ZaowuHT/JussieuServiceRobot/bom_list.xls

选型表 (Rev 0.4)
走行与运动硬件组件
编号 | 名称 | 型号 | 主要参数 | 数量 | 总价 | 评论
1 | 直流编码器减速电机 | CHR-36GP-555 | 减速比1:51 空载转速115RPM 扭矩20kg/cm 15线霍尔编码器 | 2 | 276 | 服务机器人位移速度不需要非常快，配合高扭矩电机提供更大的动力
2 | 直流电机驱动 | 7A160W | 双路L298逻辑桥电机驱动 单路最大输出电流7A | 1 | 36 | 大功率电机使用的大功率直流电机驱动，L298逻辑，控制电流与驱动电流光耦隔离
3 | AGV万向减震脚轮 | JQR25310-55ALCPU621 | 3寸，两级减震 | 1 | 112 | 两级弹簧减震悬挂，保证主动轮接地
4 | 实心橡胶承重轮 | - | 直径125mm 8mm安装轴 免维护 | 2 | 118 | 用于差速底盘
5 | 伺服电机 | SRC-04B | 回转角度270° 扭矩380kg/cm | 1 | 280 | 用于控制机器人抬头等功能，预留
6 | 伺服电机轮盘 | - | - | 1 | 36 | 出轴扭矩盘
7 | 伺服电机支架 | - | - | 1 | 20 | 伺服电机支架
8 | TTL舵机驱动器 | - | 16路 TTL电平控制 | 1 | 36 | 内置STM32控制器，与主控通过TTL串口连接，简化伺服电机控制程序
9 | STM32F407ZGT6 | STM32F407ZGT6 | Cortex-M4 核心，168Mhz主频 | 1 | 106 | 可运行FreeRTOS实时操作系统
10 | 动力锂电池组 | - | 12V 32Ah | 1 | 480 | 4A持续放电8小时，基本满足续航要求
11 | 12V稳压器 | WG8-36S1220 | 最大输出电压电流 12V 20A | 1 | 162 | 电池电压9-12V，保证电路电压稳定在12V
12 | 回转支承轴承 | - | 外径20 内径14 | 1 | 30 | 用于机器人上半身的旋转
13 | PCB制作打样 | - | - | 1 | 165 | 使用PCB综合各模块与电子部件
14 | 标准零部件 | - | - | 若干 | 待定 | 包含铝型材、电子与机械标准零部件等
 |  |  |  |  | 1857
连接与通讯，传感器，交互硬件组件
编号 | 名称 | 型号 | 主要参数 | 数量 | 总价 | 评论
1 | RS232转TTL模块 | MAX3232 | 采用RS232与上位机通讯 | 1 | 1.6 | 用于连接机器视觉模块、下位机主控
2 | SLAMWARE导航模块 | SLAMWARE Core | 激光雷达驱动、SLAM算法加速模块 | 1 | 2000 | 国产SLAM算法加速模块，内置激光雷达驱动、九轴加速度传感器
3 | 激光雷达 | RPLIDAR A2M7 | 16m扫描半径 16K采样点数 | 1 | 2200 | 激光雷达传感器
4 | Astra Pro 深度摄像头 | Astra Pro | 720p摄像头，8m深度摄像头 | 1 | 163 | 用于人脸识别，深度信息避障等
5 | 麦克风阵列 | - | 四麦克风阵列，5m拾音 | 1 | 65 | 用于语音采集，人脸识别
6 | 通用USB供电音箱 | - | - | 1 | 50 | 用于语音播报，音频回放等
7 | 超声波测距传感器 | DYP-A02-V2.0 | USART输出，分时复用 | 6 | 348 | 用于运行时障碍物检测
8 | 工控计算机 | - | J1900四核处理器 4G+32G WiFi 双路RS232 | 1 | 930 | 上位机，运行交互前端与ROS框架
9 | 15英寸触摸屏 | - | 1080p HDMI | 1 | 869 | 用于前端交互
 |  |  |  |  | 6626.6
机器人结构，外壳组件
编号 | 名称 | 型号 | 主要参数 | 数量 | 总价 | 评论
1 | 铝型材框架 | 1010/2020/4040 | - | 若干 | 待定 | 用于搭建机器人骨架
2 | 亚克力板 | 6mm/8mm/10mm | - | 若干 | 待定 | 用于机器人外壳设计
3 | 机械标准件 | - | - | 若干 | 待定 | 用于结构安装
 |  |  |  |  | 待定
