ZaowuHT/JussieuServiceRobot/pcb_bom.xlsx

PCB板BOM清单
名称 | 封装 | 数量 | 备注
供电连接器 | KF128-5.08-2P | 5
