ZaowuHT/JussieuServiceRobot/blueprint_platform/motor_wheel.SLDASM

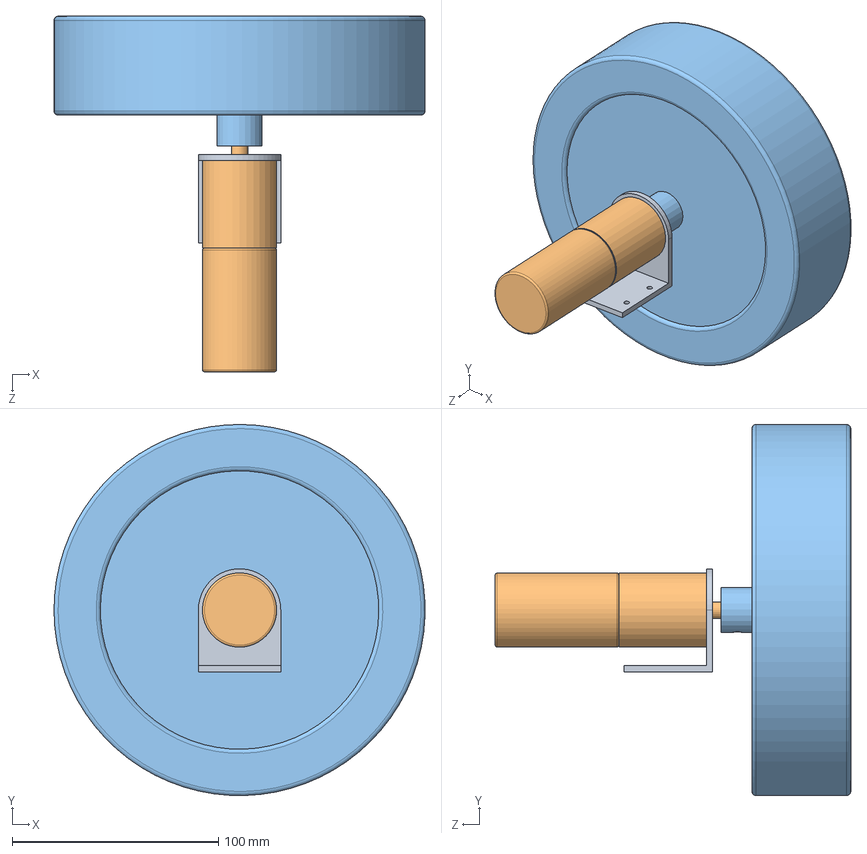
[picture p1: CAD file, 2020-09-28]
blueprint_platform/motor_wheel.SLDASM
179.9 x 180.0 x 172.5 mm
motor_plat
motor
wheel
