ZaowuHT/JussieuServiceRobot/blueprint_platform/movebase.SLDASM

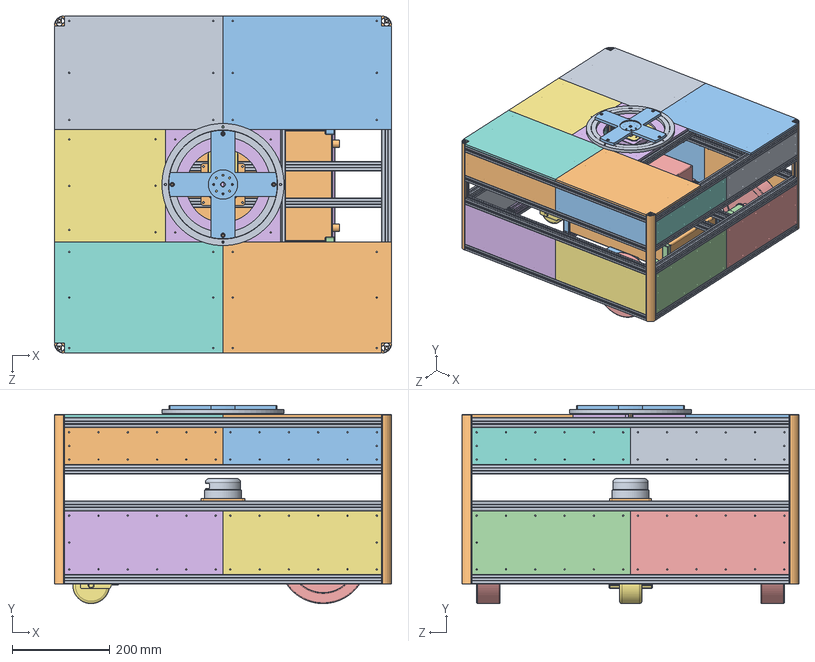
[picture p2: CAD file, 2020-09-28]
blueprint_platform/movebase.SLDASM
690.2 x 405.8 x 690.1 mm
2020R_Movebase x 4
motor_plat x 2
motor x 2
wheel x 2
wheel_3
wheel_3_plat
battery
battery_plat x 2
battery_plat_mirror x 2
host_computer
pcb
pcb_plat
stud_M3x40 x 4
lidar
lidar_plat
battery_stabilizer
battery_stabilizer_plat
servo
servo_plat
servo_wheel
turntable
stud_M5x8 x 8
turntable_plat
acrylic_325x130_left_down_l
acrylic_325x130_left_down_r
acrylic_325x130_front_down_l
acrylic_325x130_front_down_r
acrylic_325x130_right_down_l
acrylic_325x130_right_down_r
acrylic_325x130_rear_down_l
acrylic_325x130_rear_down_r
acrylic_325x75.8_front_up_l
acrylic_325x75.8_front_up_r
acrylic_325x75.8_rear_up_l
acrylic_325x75.8_rear_up_r
acrylic_325x75.8_left_up_l
acrylic_325x75.8_left_up_r
acrylic_325x75.8_right_up_l
acrylic_325x75.8_right_up_r
acrylic_256x225.45_top_mid
acrylic_227x230.45_top_front_mid
acrylic_227x345_top_left_l
acrylic_227x345_top_right_r
acrylic_227x345_top_left_r
acrylic_227x345_top_right_l
