ZaowuHT/JussieuServiceRobot/blueprint_prototype/motor_wheel.SLDASM

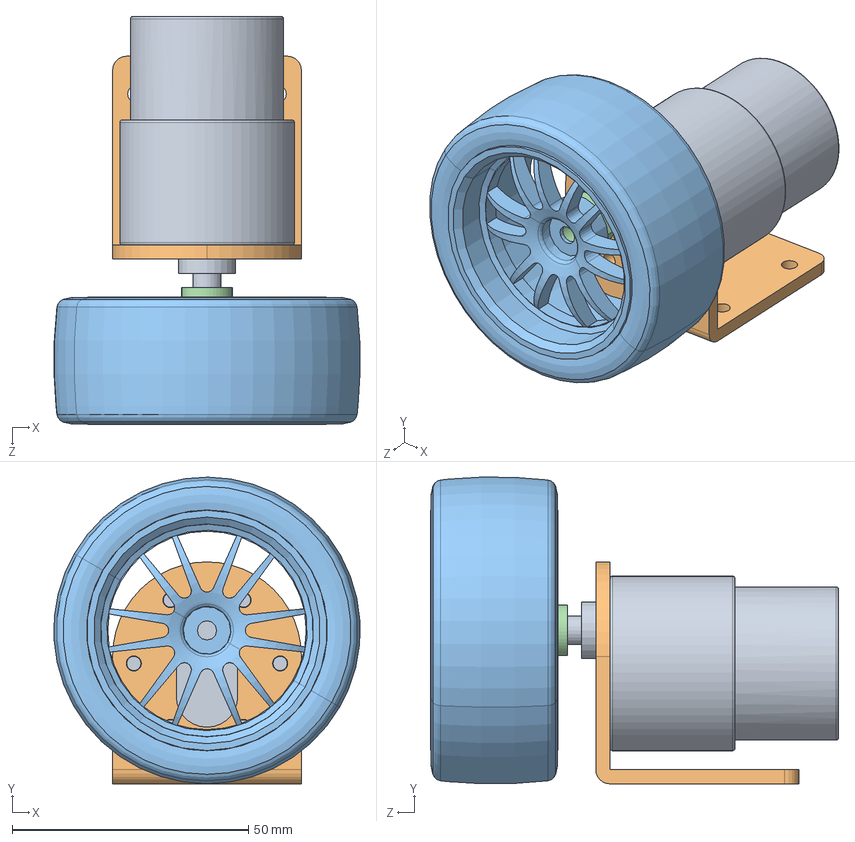
[picture p3: CAD file, 2020-09-28]
blueprint_prototype/motor_wheel.SLDASM
64.8 x 65.0 x 86.4 mm
motor
plat_motor
wheel
connector
