ZaowuHT/JussieuServiceRobot/blueprint_prototype/prototype.SLDASM

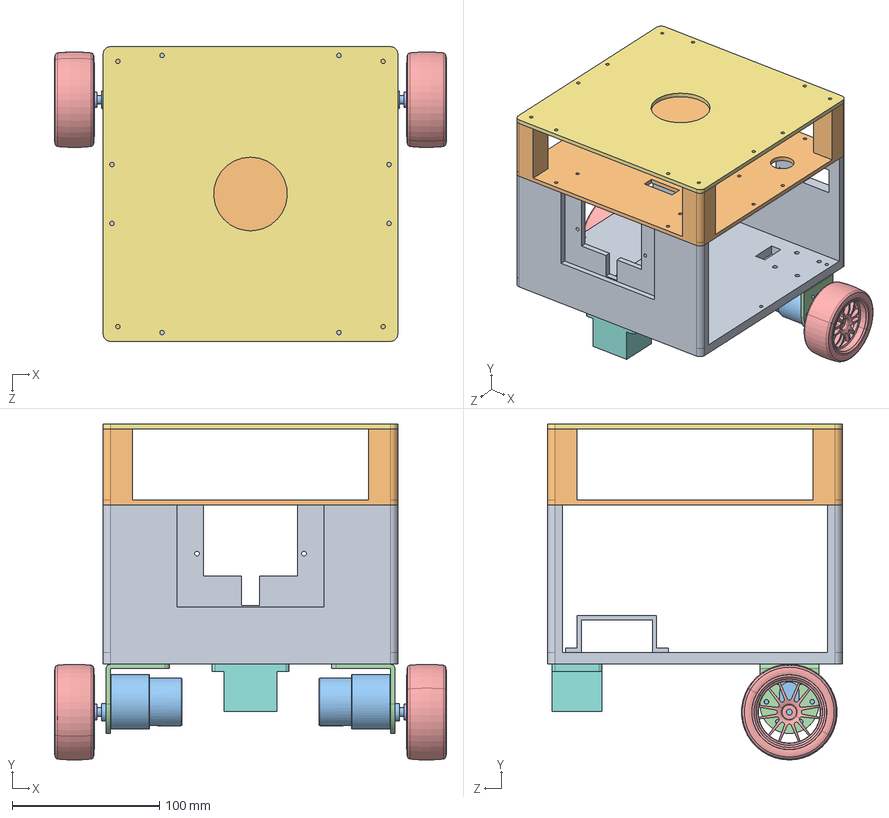
[picture p4: CAD file, 2020-09-28]
blueprint_prototype/prototype.SLDASM
266.0 x 228.0 x 200.0 mm
plat_main
plat_mid
motor x 2
plat_motor x 2
wheel x 2
connector x 2
plat_up
plat_wheel
batt_plat
