ZaowuHT/JussieuServiceRobot/blueprint_prototype/plat_main.SLDPRT

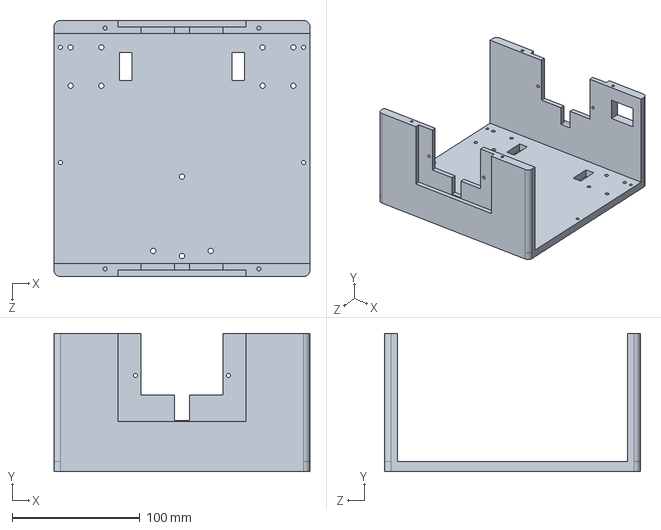
[picture p5: CAD file, 2020-09-28]
blueprint_prototype/plat_main.SLDPRT
200.0 x 108.0 x 200.0 mm
