ZaowuHT/JussieuServiceRobot/blueprint_platform/robot_body.SLDASM

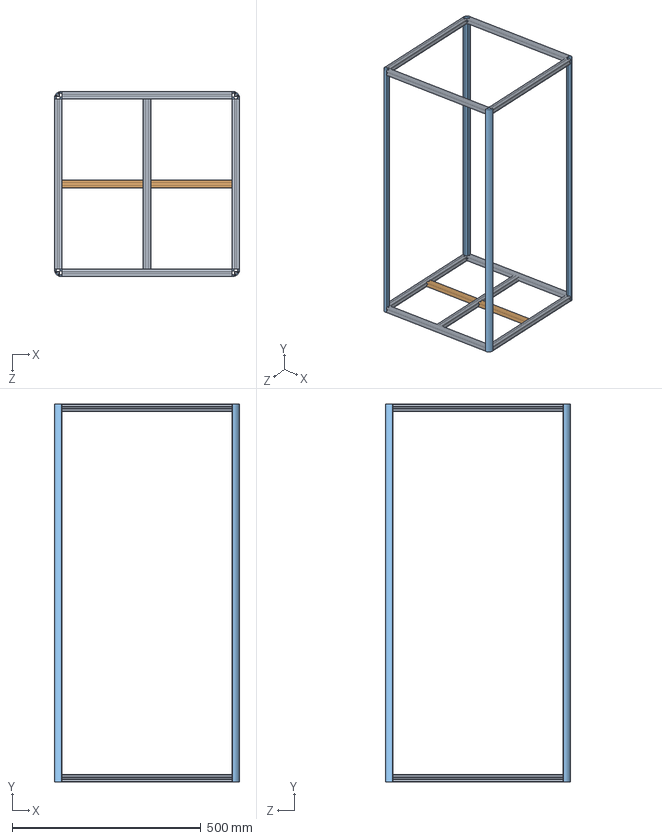
[picture p6: CAD file, 2020-09-28]
blueprint_platform/robot_body.SLDASM
490.2 x 1000.0 x 490.2 mm
2020R_body x 4
