ZaowuHT/JussieuServiceRobot/blueprint_platform/acrylic/acrylic_227x345_top_right_l.SLDPRT

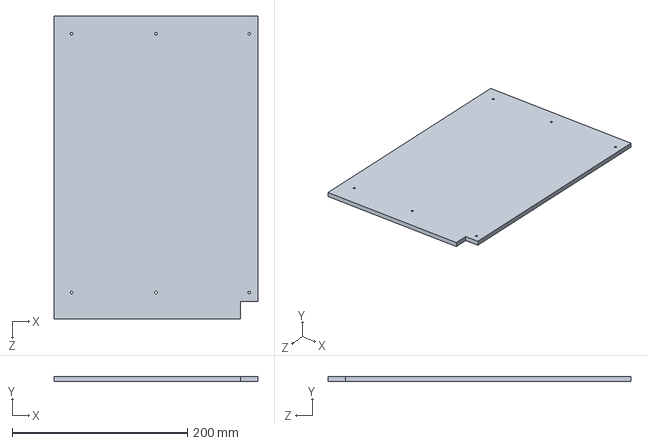
[picture p7: CAD file, 2020-09-28]
blueprint_platform/acrylic/acrylic_227x345_top_right_l.SLDPRT
232.5 x 6.00 x 345.0 mm
