ZaowuHT/JussieuServiceRobot/blueprint_platform/aluminum_profile/2040_216.SLDPRT

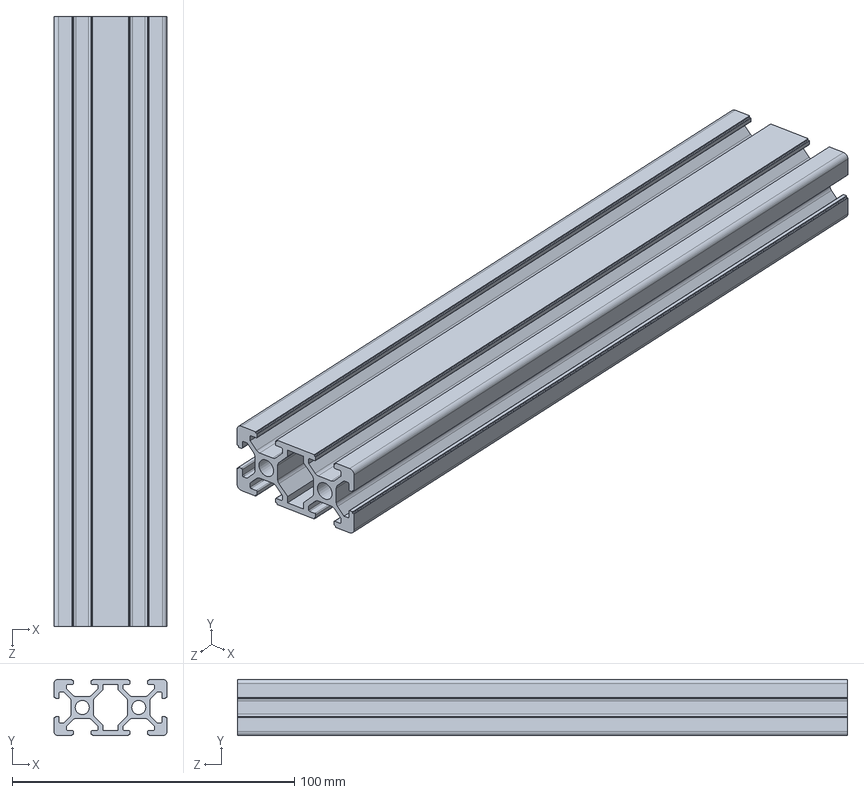
[picture p8: CAD file, 2020-09-28]
blueprint_platform/aluminum_profile/2040_216.SLDPRT
40.0 x 20.0 x 216.0 mm
