ZaowuHT/JussieuServiceRobot/blueprint_platform/pcb_plat.SLDPRT

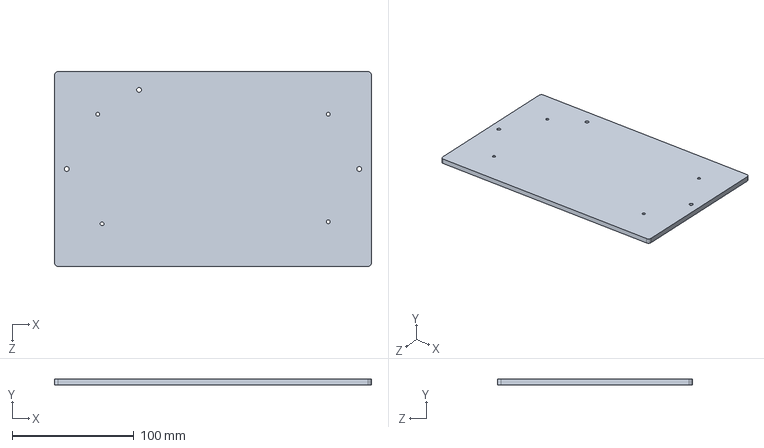
[picture p9: CAD file, 2020-09-28]
blueprint_platform/pcb_plat.SLDPRT
260.0 x 5.00 x 160.0 mm
