ZaowuHT/JussieuServiceRobot/blueprint_prototype/motor.SLDPRT

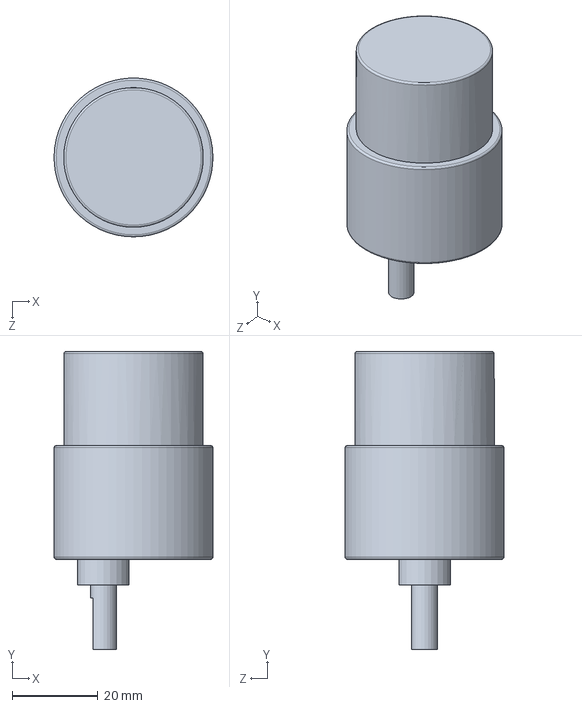
[picture p10: CAD file, 2020-09-28]
blueprint_prototype/motor.SLDPRT
37.0 x 69.4 x 37.0 mm
