ZaowuHT/JussieuServiceRobot/blueprint_platform/acrylic/acrylic_325x75.8_right_up_l.SLDPRT

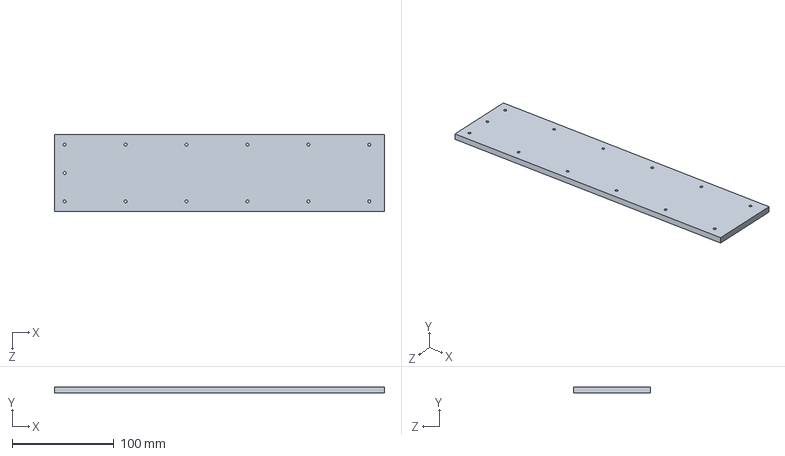
[picture p11: CAD file, 2020-09-28]
blueprint_platform/acrylic/acrylic_325x75.8_right_up_l.SLDPRT
325.0 x 6.00 x 75.8 mm
