ZaowuHT/JussieuServiceRobot/blueprint_platform/aluminum_profile/2020R_Movebase.SLDPRT

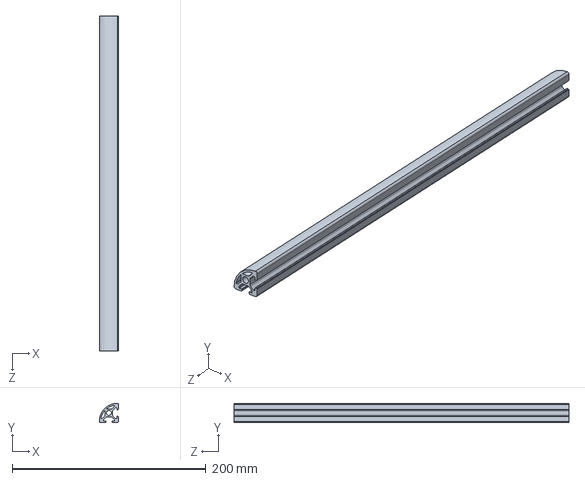
[picture p12: CAD file, 2020-09-28]
blueprint_platform/aluminum_profile/2020R_Movebase.SLDPRT
20.1 x 20.1 x 346.0 mm
