ZaowuHT/JussieuServiceRobot/blueprint_prototype/plat_wheel.SLDPRT

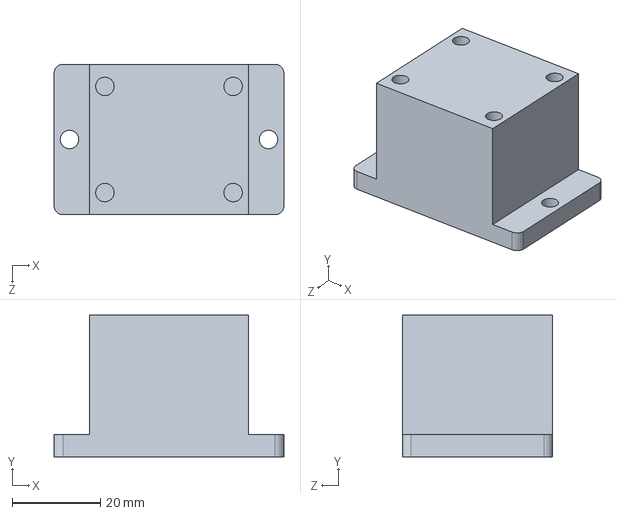
[picture p13: CAD file, 2020-09-28]
blueprint_prototype/plat_wheel.SLDPRT
52.0 x 32.0 x 34.0 mm
