ZaowuHT/JussieuServiceRobot/blueprint_platform/aluminum_profile/2020R_body.SLDPRT

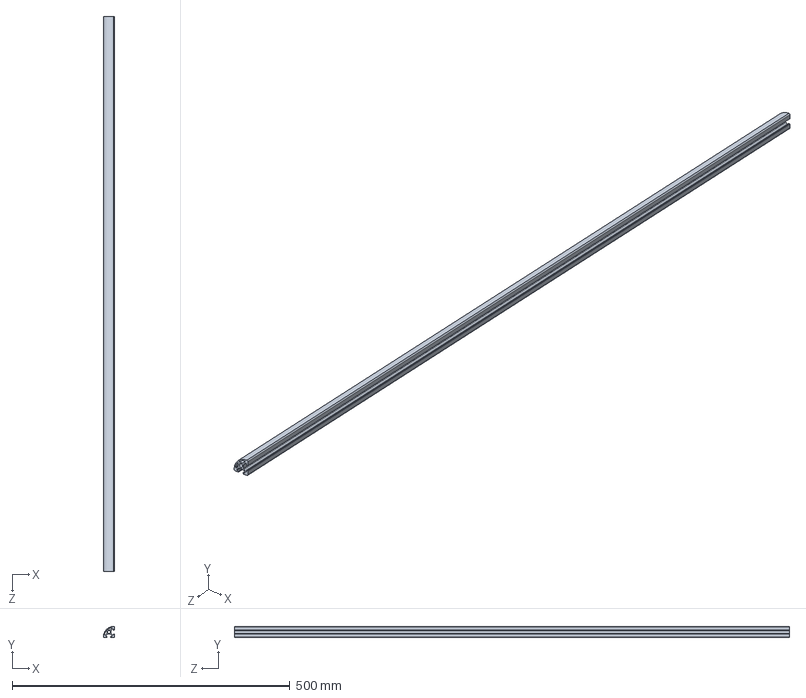
[picture p14: CAD file, 2020-09-28]
blueprint_platform/aluminum_profile/2020R_body.SLDPRT
20.1 x 20.1 x 1000.0 mm
