ZaowuHT/JussieuServiceRobot/blueprint_platform/motor.SLDPRT

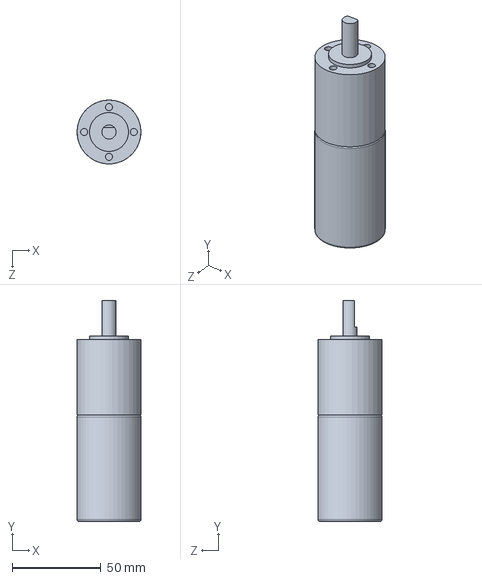
[picture p15: CAD file, 2020-09-28]
blueprint_platform/motor.SLDPRT
36.0 x 124.5 x 36.0 mm
