ZaowuHT/JussieuServiceRobot/blueprint_prototype/batt_plat.SLDPRT

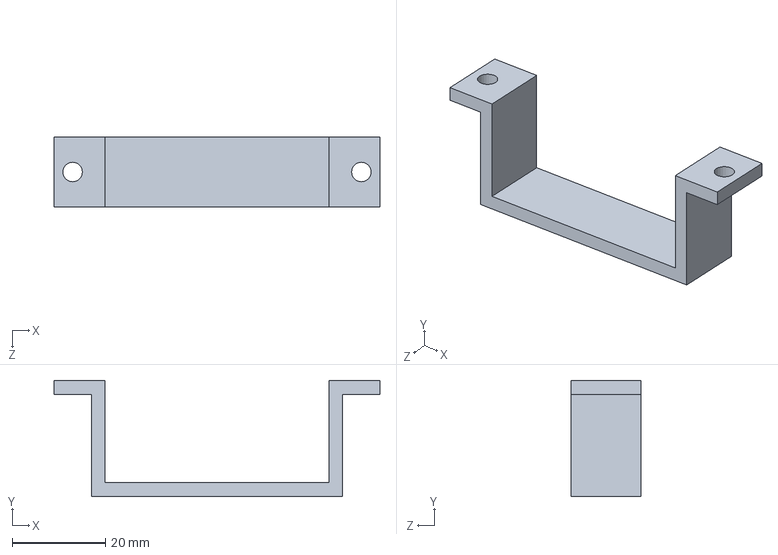
[picture p16: CAD file, 2020-09-28]
blueprint_prototype/batt_plat.SLDPRT
70.0 x 25.0 x 15.0 mm
