ZaowuHT/JussieuServiceRobot/blueprint_platform/aluminum_profile/2020_450.SLDPRT

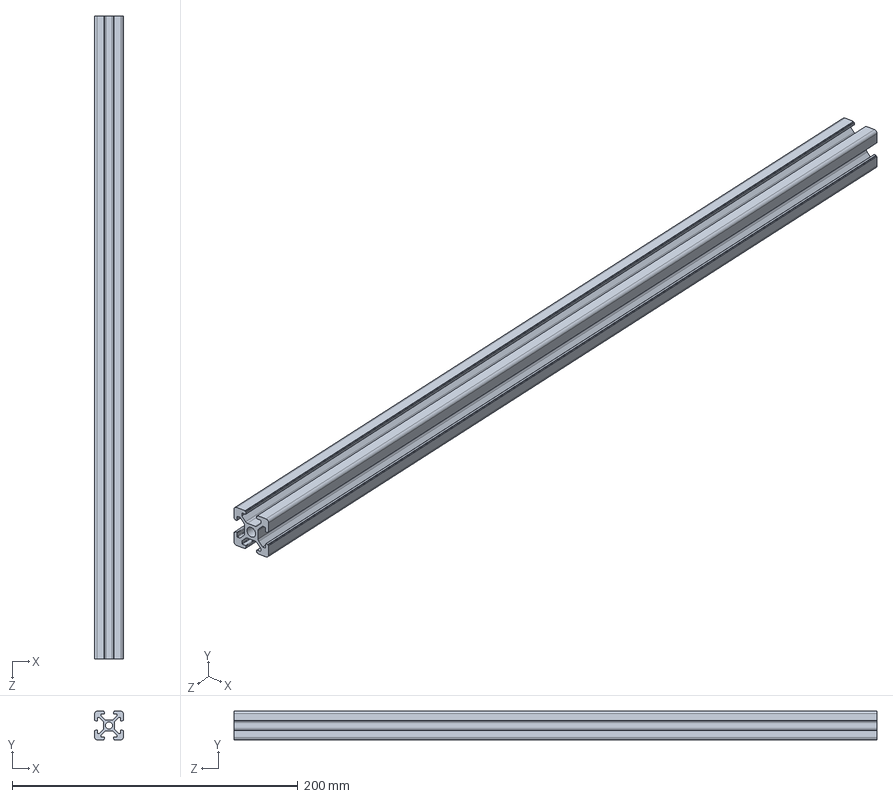
[picture p17: CAD file, 2020-09-28]
blueprint_platform/aluminum_profile/2020_450.SLDPRT
20.0 x 20.0 x 450.0 mm
