ZaowuHT/JussieuServiceRobot/blueprint_platform/lidar_plat.SLDPRT

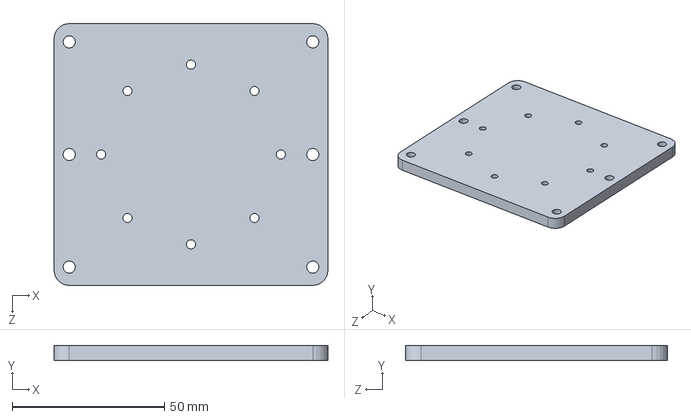
[picture p18: CAD file, 2020-09-28]
blueprint_platform/lidar_plat.SLDPRT
90.0 x 5.00 x 86.0 mm
