ZaowuHT/JussieuServiceRobot/blueprint_prototype/plat_up.SLDPRT

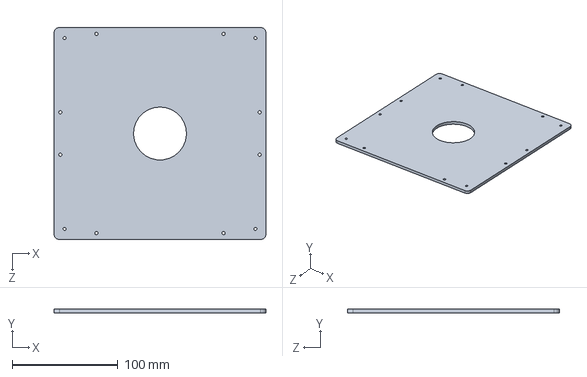
[picture p19: CAD file, 2020-09-28]
blueprint_prototype/plat_up.SLDPRT
200.0 x 3.50 x 200.0 mm
