ZaowuHT/JussieuServiceRobot/blueprint_platform/acrylic/acrylic_256x225.45_top_mid.SLDPRT

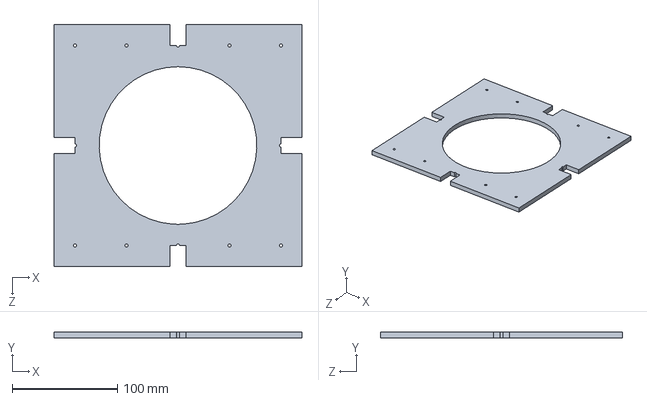
[picture p20: CAD file, 2020-09-28]
blueprint_platform/acrylic/acrylic_256x225.45_top_mid.SLDPRT
236.0 x 6.00 x 230.4 mm
