ZaowuHT/JussieuServiceRobot/blueprint_platform/battery_stabilizer.SLDPRT

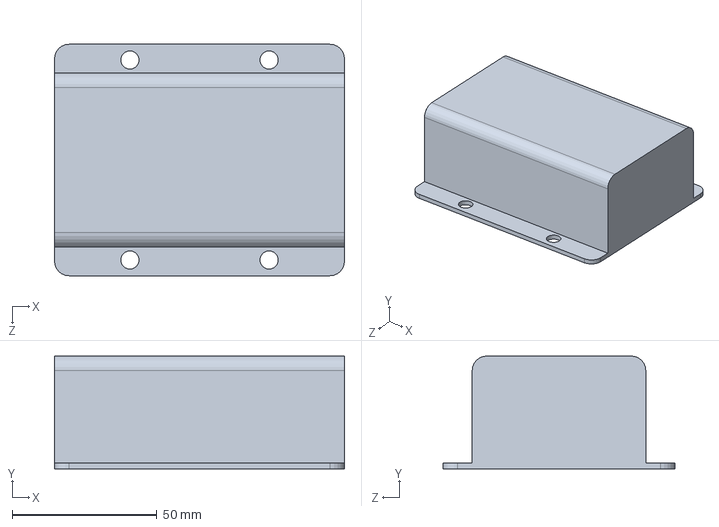
[picture p21: CAD file, 2020-09-28]
blueprint_platform/battery_stabilizer.SLDPRT
100.2 x 39.0 x 80.0 mm
