ZaowuHT/JussieuServiceRobot/blueprint_prototype/wheel.SLDPRT

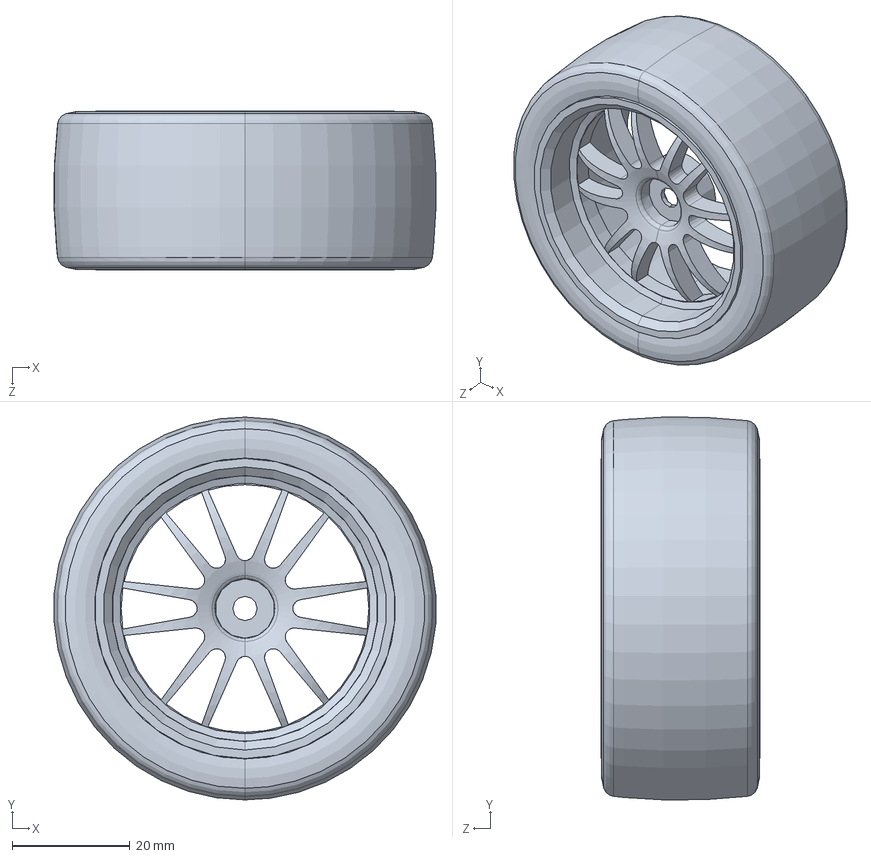
[picture p22: CAD file, 2020-09-28]
blueprint_prototype/wheel.SLDPRT
64.8 x 64.9 x 27.0 mm
