ZaowuHT/JussieuServiceRobot/blueprint_platform/acrylic/acrylic_325x130_front_down_l.SLDPRT

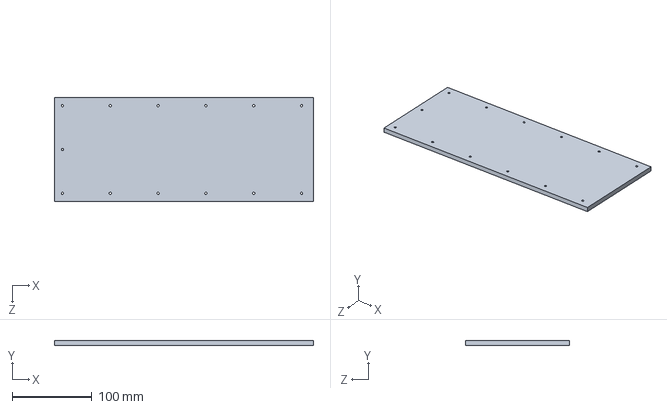
[picture p23: CAD file, 2020-09-28]
blueprint_platform/acrylic/acrylic_325x130_front_down_l.SLDPRT
325.0 x 6.00 x 130.0 mm
