ZaowuHT/JussieuServiceRobot/blueprint_platform/aluminum_profile/2020_Connect.SLDPRT

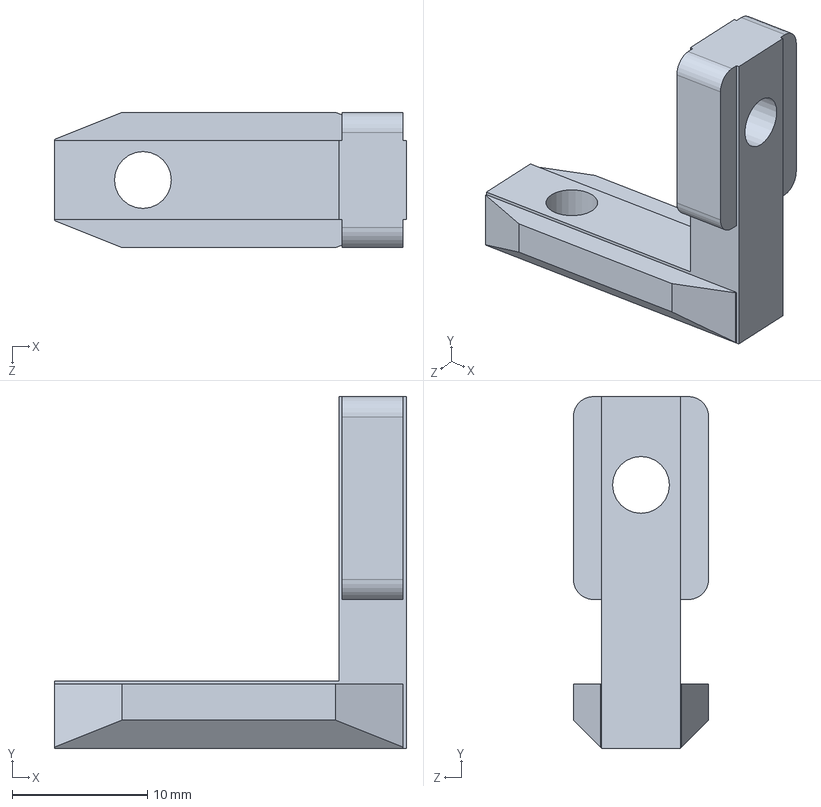
[picture p24: CAD file, 2020-09-28]
blueprint_platform/aluminum_profile/2020_Connect.SLDPRT
26.0 x 26.0 x 10.0 mm
