ZaowuHT/JussieuServiceRobot/blueprint_platform/servo.SLDPRT

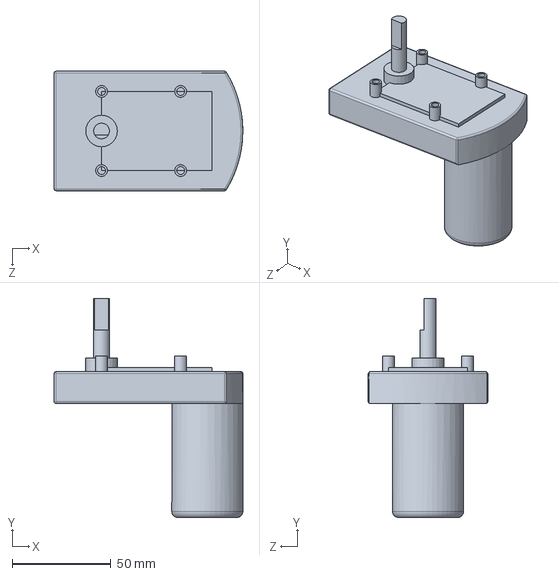
[picture p25: CAD file, 2020-09-28]
blueprint_platform/servo.SLDPRT
95.5 x 110.8 x 60.5 mm
