ZaowuHT/JussieuServiceRobot/blueprint_prototype/plat_motor.SLDPRT

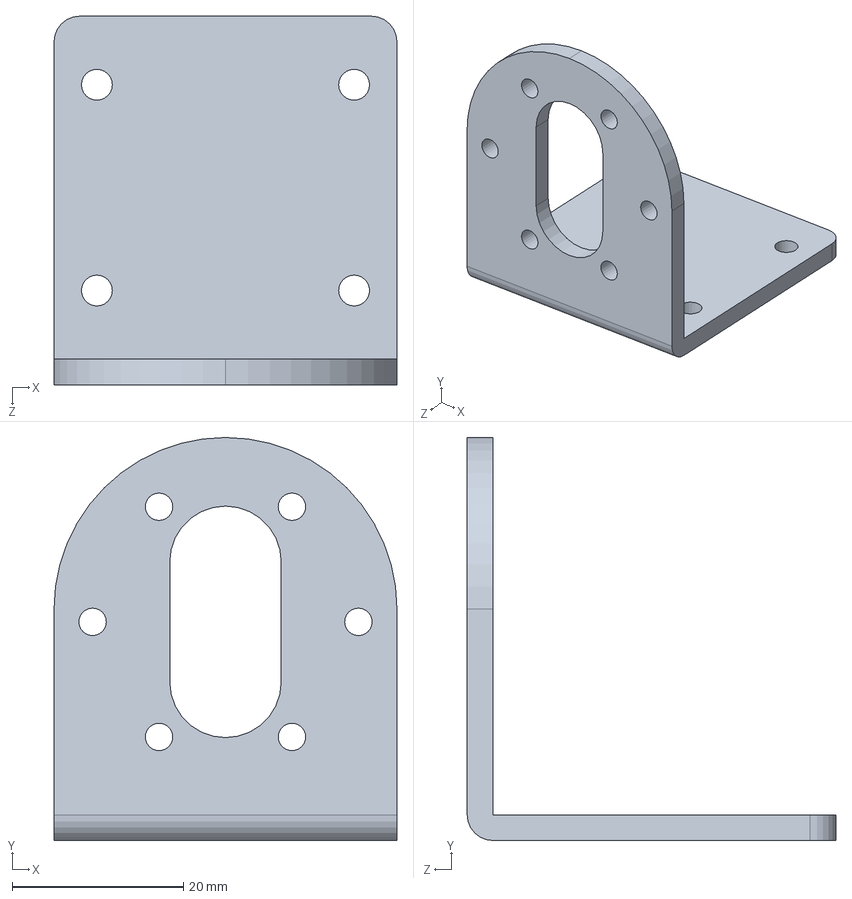
[picture p26: CAD file, 2020-09-28]
blueprint_prototype/plat_motor.SLDPRT
40.0 x 47.0 x 43.0 mm
