ZaowuHT/JussieuServiceRobot/blueprint_platform/aluminum_profile/2020_335.SLDPRT

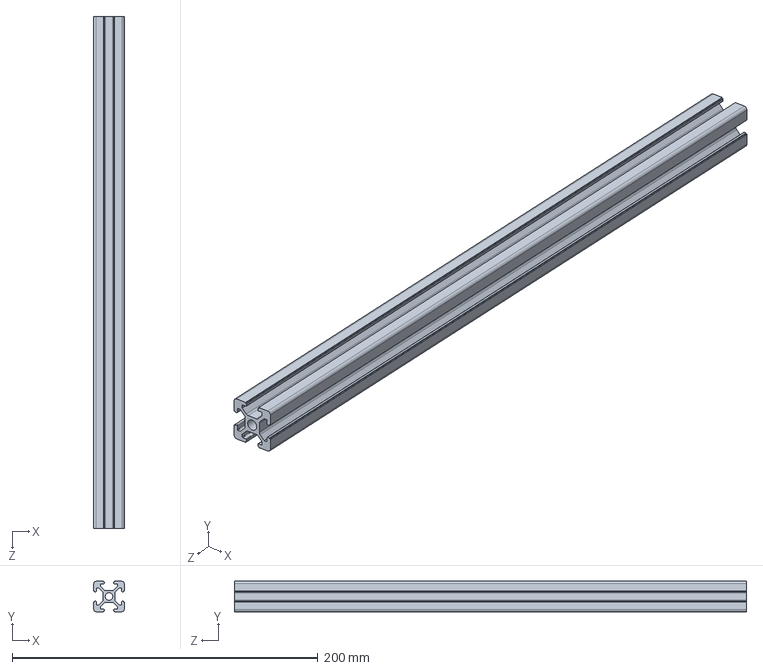
[picture p27: CAD file, 2020-09-28]
blueprint_platform/aluminum_profile/2020_335.SLDPRT
20.0 x 20.0 x 335.0 mm
