ZaowuHT/JussieuServiceRobot/blueprint_platform/aluminum_profile/2020_410.SLDPRT

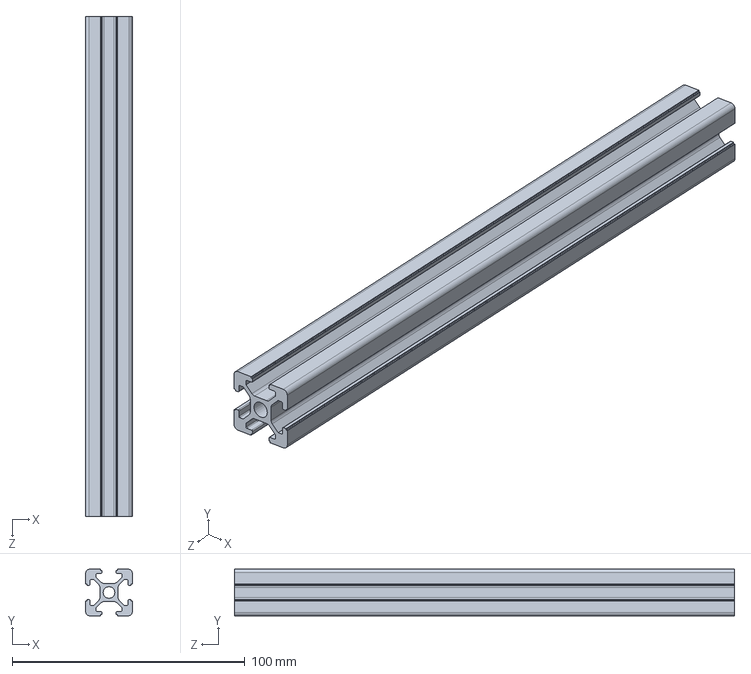
[picture p28: CAD file, 2020-09-28]
blueprint_platform/aluminum_profile/2020_410.SLDPRT
20.0 x 20.0 x 215.0 mm
