ZaowuHT/JussieuServiceRobot/blueprint_platform/battery_plat.SLDPRT

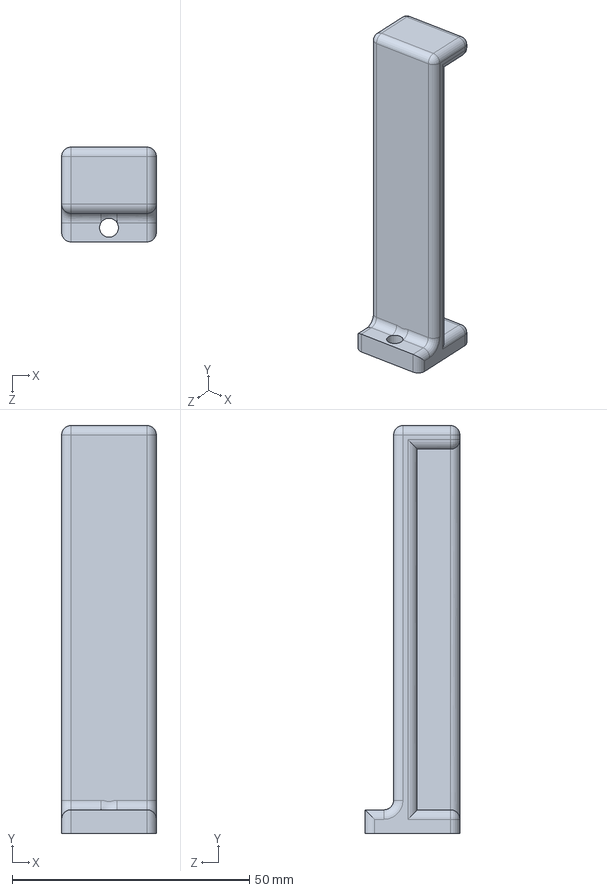
[picture p29: CAD file, 2020-09-28]
blueprint_platform/battery_plat.SLDPRT
20.0 x 86.0 x 20.0 mm
