ZaowuHT/JussieuServiceRobot/blueprint_prototype/plat_mid.SLDPRT

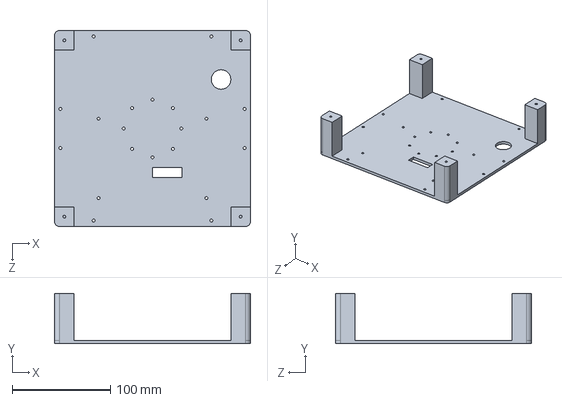
[picture p30: CAD file, 2020-09-28]
blueprint_prototype/plat_mid.SLDPRT
200.0 x 51.5 x 200.0 mm
