ZaowuHT/JussieuServiceRobot/blueprint_platform/battery_stabilizer_plat.SLDPRT

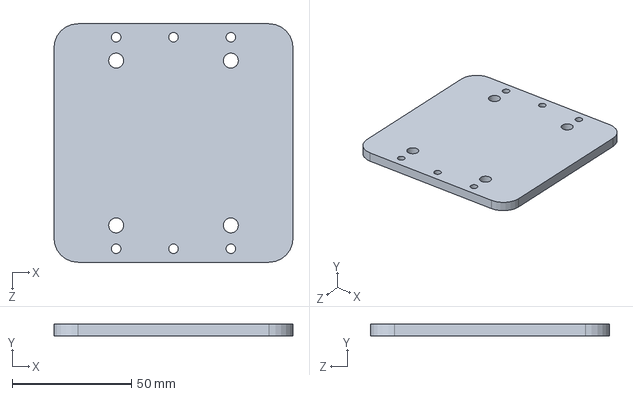
[picture p31: CAD file, 2020-09-28]
blueprint_platform/battery_stabilizer_plat.SLDPRT
100.2 x 5.00 x 100.0 mm
