ZaowuHT/JussieuServiceRobot/blueprint_platform/aluminum_profile/2020.SLDPRT

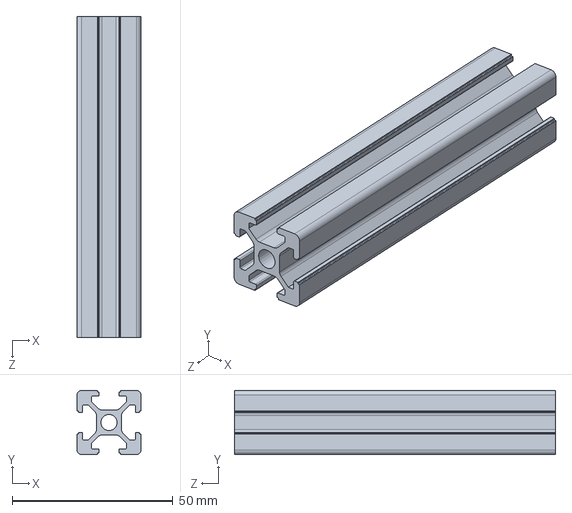
[picture p32: CAD file, 2020-09-28]
blueprint_platform/aluminum_profile/2020.SLDPRT
20.0 x 20.0 x 100.0 mm
