ZaowuHT/JussieuServiceRobot/blueprint_platform/body_speaker.SLDPRT

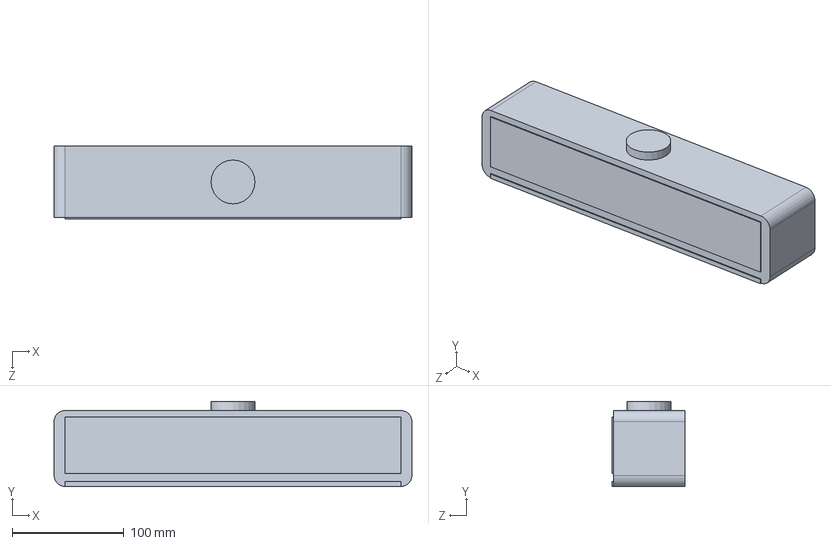
[picture p33: CAD file, 2020-09-28]
blueprint_platform/body_speaker.SLDPRT
320.0 x 76.0 x 65.0 mm
