ZaowuHT/JussieuServiceRobot/blueprint_prototype/connector.SLDPRT

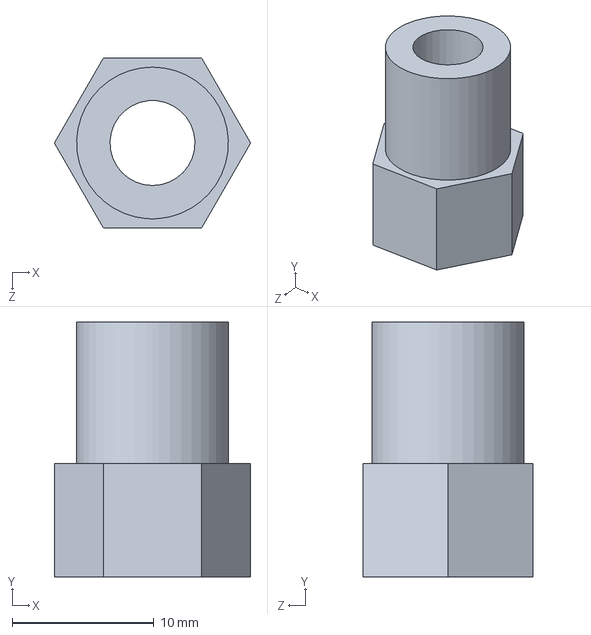
[picture p34: CAD file, 2020-09-28]
blueprint_prototype/connector.SLDPRT
13.9 x 18.0 x 12.0 mm
