ZaowuHT/JussieuServiceRobot/blueprint_platform/acrylic/acrylic_227x345_top_left_r.SLDPRT

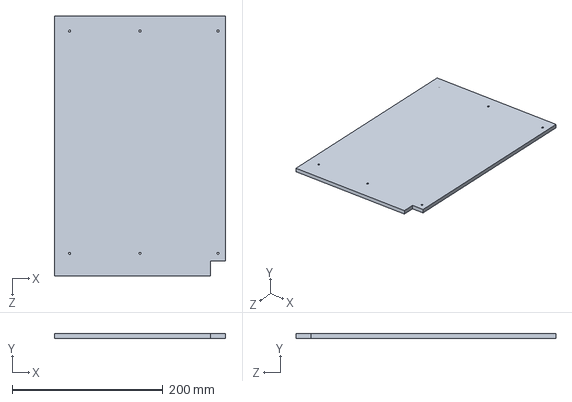
[picture p35: CAD file, 2020-09-28]
blueprint_platform/acrylic/acrylic_227x345_top_left_r.SLDPRT
227.0 x 6.00 x 345.0 mm
