ZaowuHT/JussieuServiceRobot/blueprint_platform/motor_plat.SLDPRT

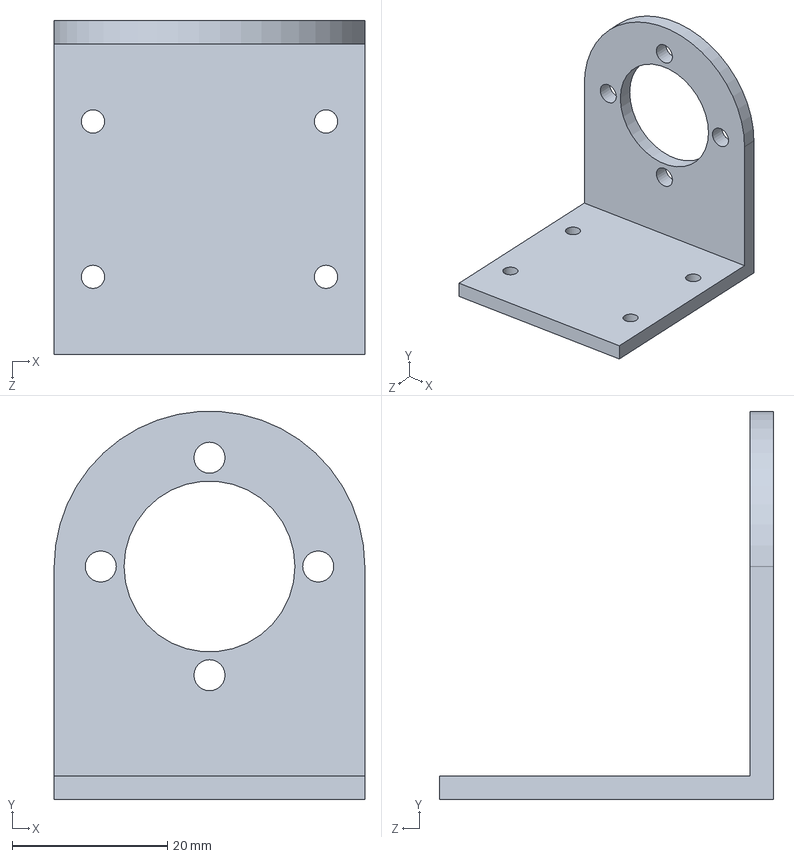
[picture p36: CAD file, 2020-09-28]
blueprint_platform/motor_plat.SLDPRT
40.0 x 50.0 x 43.0 mm
