ZaowuHT/JussieuServiceRobot/blueprint_platform/aluminum_profile/2020_90.SLDPRT

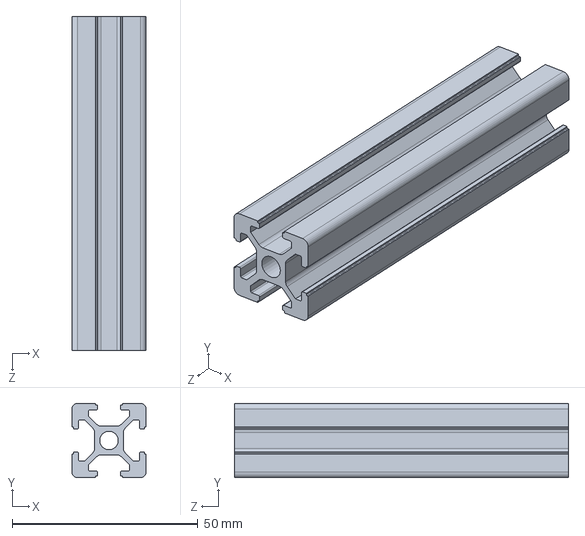
[picture p37: CAD file, 2020-09-28]
blueprint_platform/aluminum_profile/2020_90.SLDPRT
20.0 x 20.0 x 90.0 mm
