ZaowuHT/JussieuServiceRobot/blueprint_platform/wheel.SLDPRT

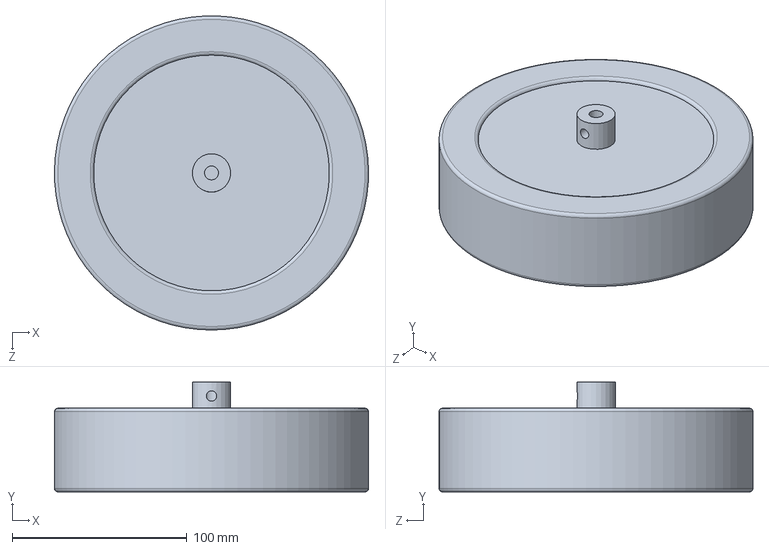
[picture p38: CAD file, 2020-09-28]
blueprint_platform/wheel.SLDPRT
180.0 x 63.0 x 179.9 mm
