ZaowuHT/JussieuServiceRobot/blueprint_platform/aluminum_profile/2020_650.SLDPRT

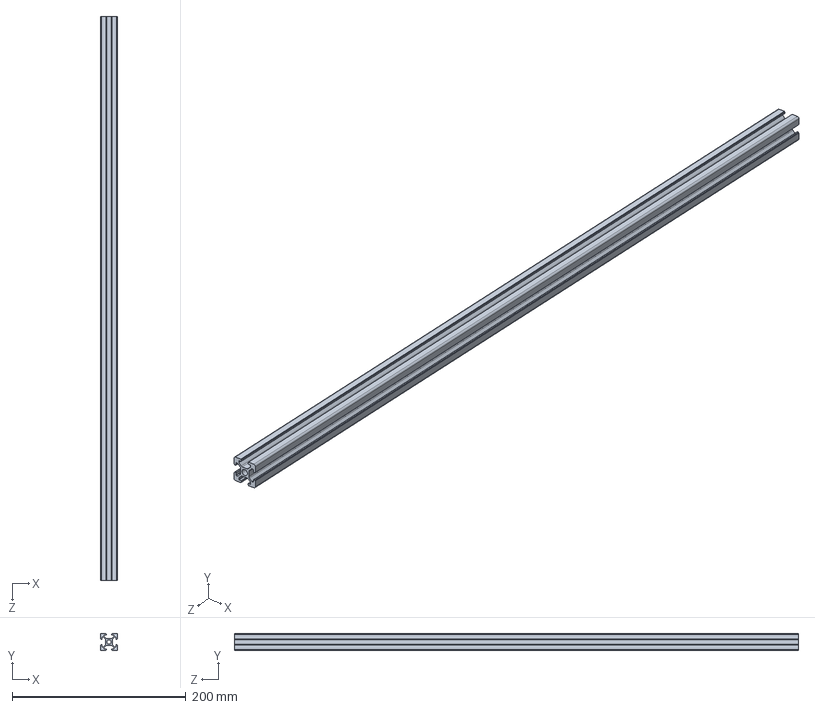
[picture p39: CAD file, 2020-09-28]
blueprint_platform/aluminum_profile/2020_650.SLDPRT
20.0 x 20.0 x 650.0 mm
