ZaowuHT/JussieuServiceRobot/blueprint_platform/wheel_3_plat.SLDPRT

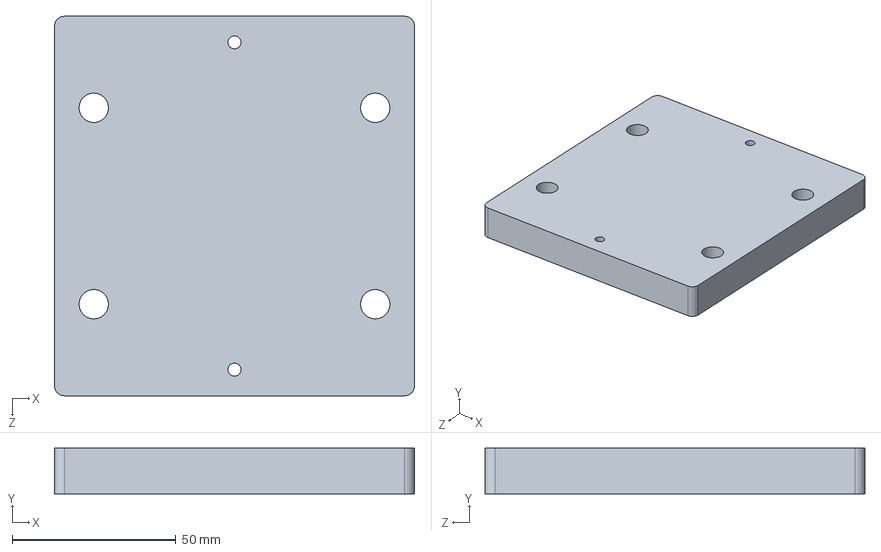
[picture p40: CAD file, 2020-09-28]
blueprint_platform/wheel_3_plat.SLDPRT
110.0 x 14.0 x 116.0 mm
