ZaowuHT/JussieuServiceRobot/blueprint_platform/touch_screen.SLDPRT

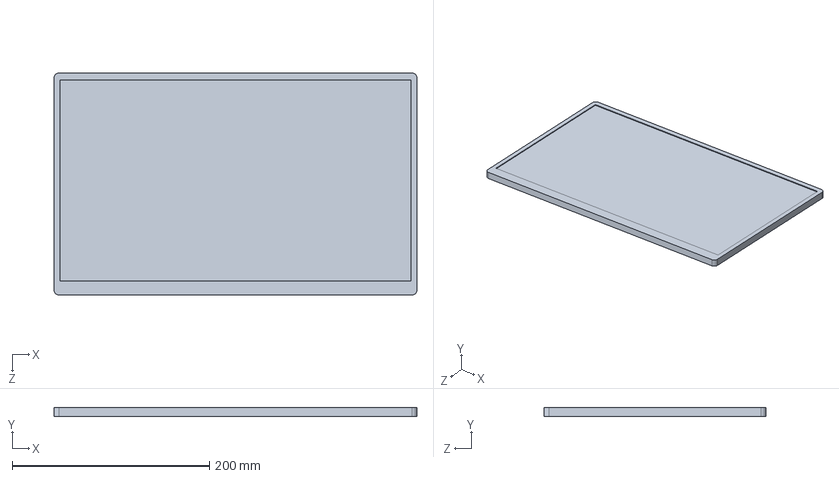
[picture p41: CAD file, 2020-09-28]
blueprint_platform/touch_screen.SLDPRT
368.0 x 9.00 x 225.0 mm
