ZaowuHT/JussieuServiceRobot/blueprint_platform/lidar.SLDPRT

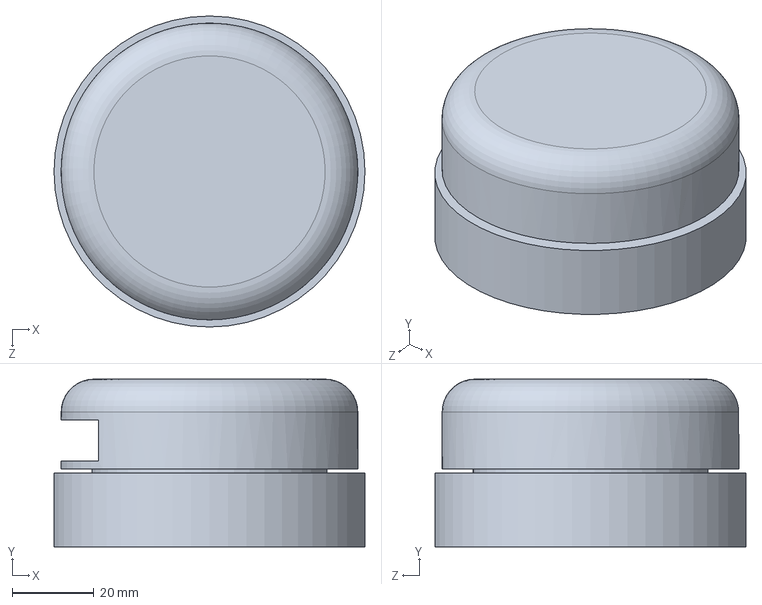
[picture p42: CAD file, 2020-09-28]
blueprint_platform/lidar.SLDPRT
76.0 x 41.0 x 76.0 mm
