ZaowuHT/JussieuServiceRobot/blueprint_platform/servo_plat.SLDPRT

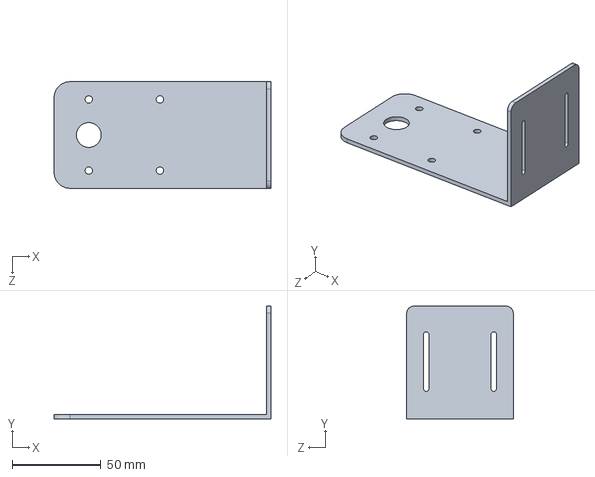
[picture p43: CAD file, 2020-09-28]
blueprint_platform/servo_plat.SLDPRT
122.0 x 63.5 x 60.0 mm
