ZaowuHT/JussieuServiceRobot/blueprint_platform/host_computer.SLDPRT

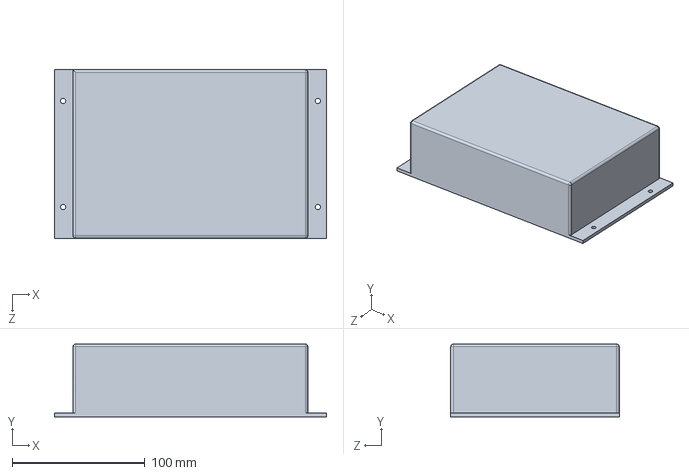
[picture p44: CAD file, 2020-09-28]
blueprint_platform/host_computer.SLDPRT
205.0 x 55.0 x 127.0 mm
