ZaowuHT/JussieuServiceRobot/blueprint_platform/pcb.SLDPRT

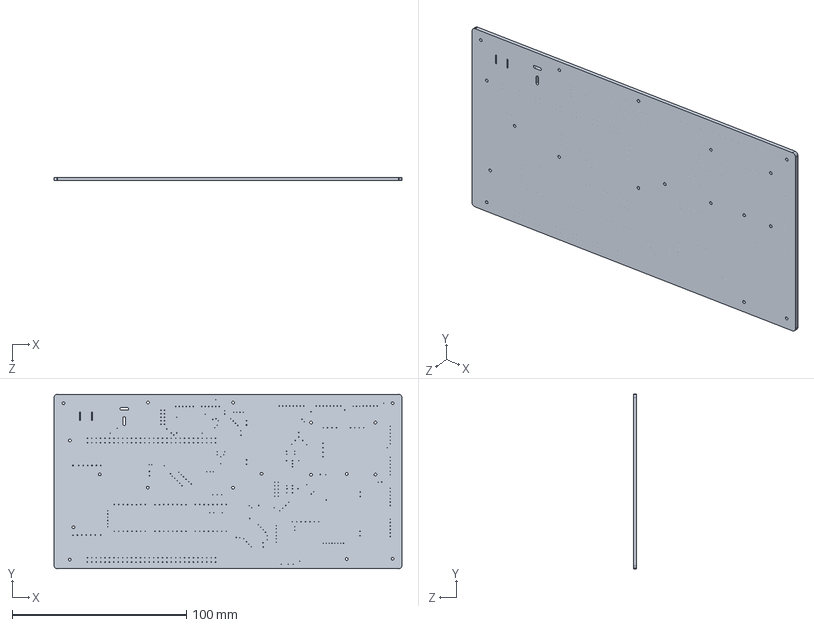
[picture p45: CAD file, 2020-09-28]
blueprint_platform/pcb.SLDPRT
200.0 x 100.3 x 2.00 mm
