ZaowuHT/JussieuServiceRobot/blueprint_platform/wheel_3.SLDPRT

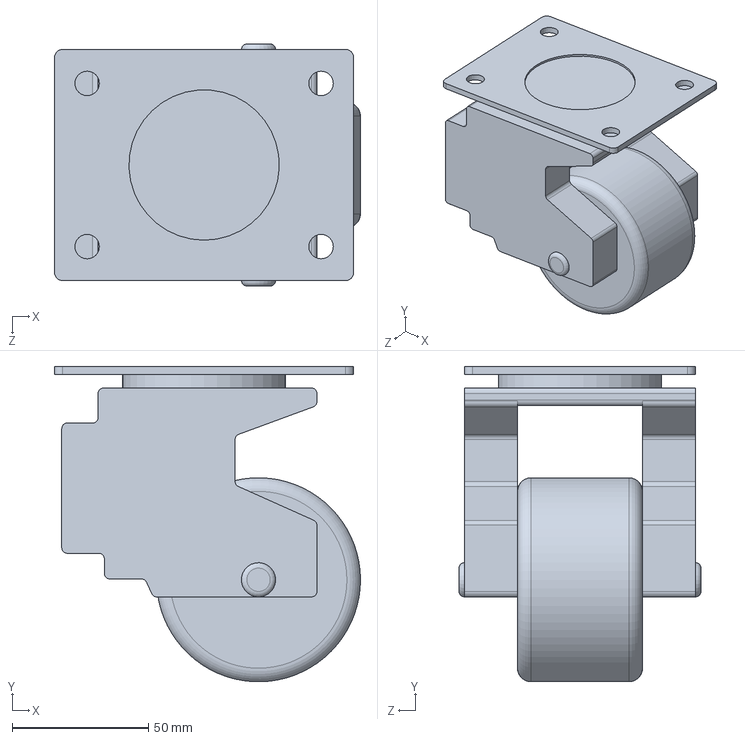
[picture p46: CAD file, 2020-09-28]
blueprint_platform/wheel_3.SLDPRT
112.5 x 116.0 x 89.0 mm
