ZaowuHT/JussieuServiceRobot/blueprint_platform/stud_M3x40.SLDPRT

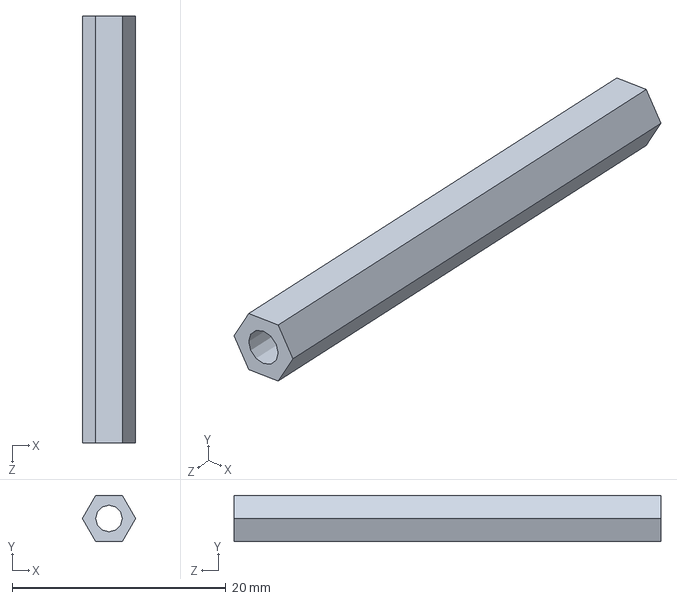
[picture p47: CAD file, 2020-09-28]
blueprint_platform/stud_M3x40.SLDPRT
5.00 x 4.33 x 40.0 mm
