ZaowuHT/JussieuServiceRobot/blueprint_platform/acrylic/acrylic_227x230.45_top_front_mid.SLDPRT

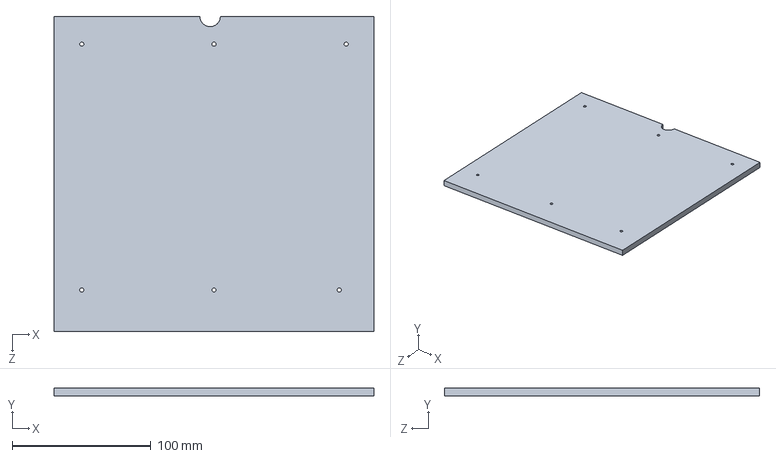
[picture p48: CAD file, 2020-09-28]
blueprint_platform/acrylic/acrylic_227x230.45_top_front_mid.SLDPRT
230.4 x 6.00 x 227.0 mm
