ZaowuHT/JussieuServiceRobot/blueprint_platform/battery.SLDPRT

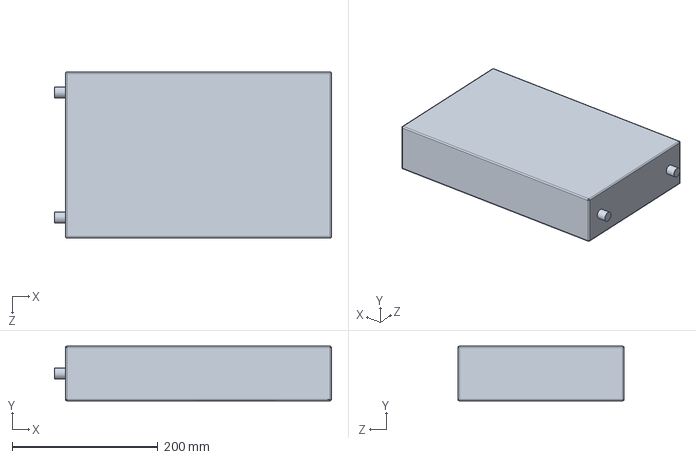
[picture p49: CAD file, 2020-09-28]
blueprint_platform/battery.SLDPRT
380.0 x 75.0 x 228.0 mm
