ZaowuHT/JussieuServiceRobot/blueprint_platform/turntable.SLDPRT

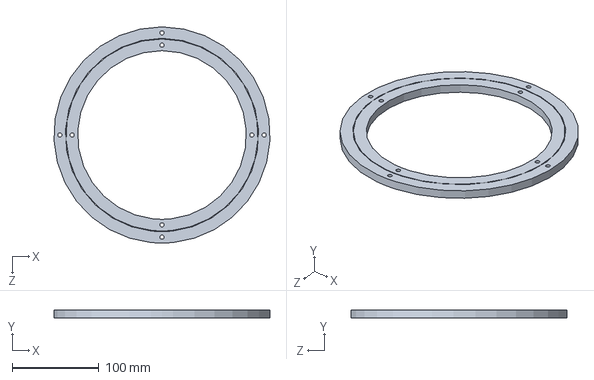
[picture p50: CAD file, 2020-09-28]
blueprint_platform/turntable.SLDPRT
249.7 x 9.00 x 250.0 mm
