ZaowuHT/JussieuServiceRobot/blueprint_platform/turntable_plat.SLDPRT

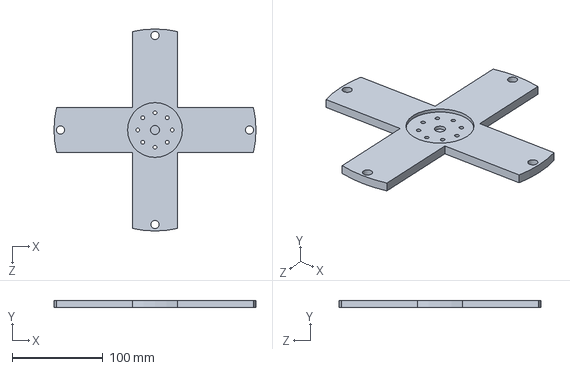
[picture p51: CAD file, 2020-09-28]
blueprint_platform/turntable_plat.SLDPRT
222.0 x 8.00 x 222.0 mm
