ZaowuHT/JussieuServiceRobot/blueprint_platform/servo_wheel.SLDPRT

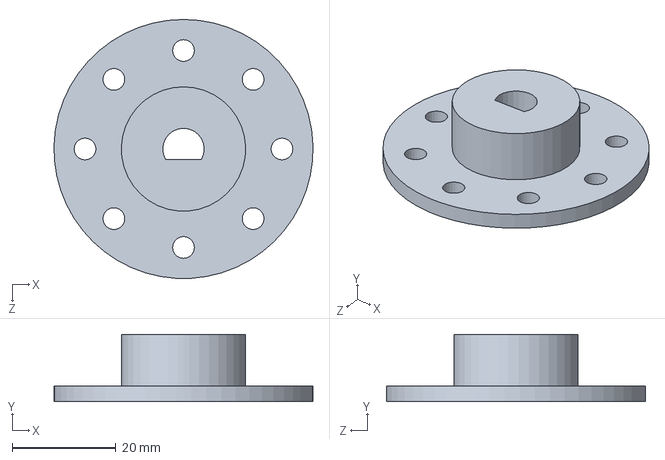
[picture p52: CAD file, 2020-09-28]
blueprint_platform/servo_wheel.SLDPRT
50.0 x 13.0 x 50.0 mm
