ZaowuHT/JussieuServiceRobot/blueprint_platform/stud_M5x8.SLDPRT

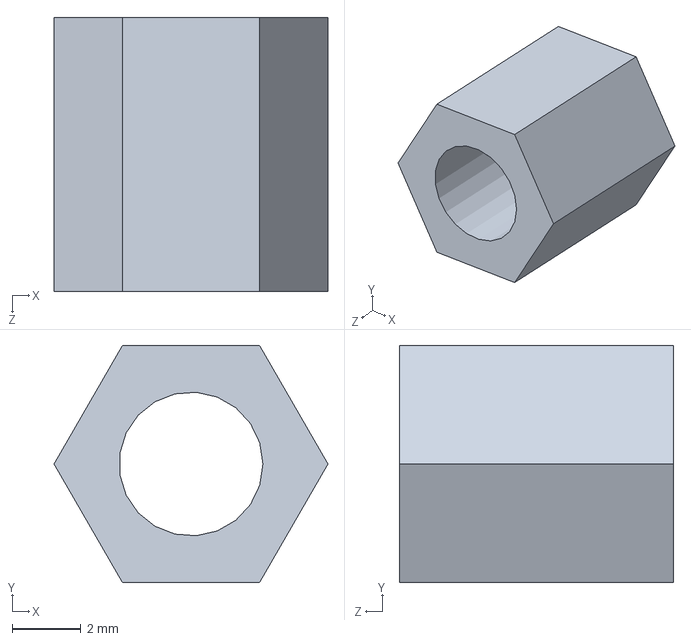
[picture p53: CAD file, 2020-09-28]
blueprint_platform/stud_M5x8.SLDPRT
8.00 x 6.93 x 8.00 mm
