ZaowuHT/JussieuServiceRobot/(list of files, cad)

Other CAD files:
blueprint_platform/acrylic/acrylic_227x345_top_right_r.SLDPRT
blueprint_platform/aluminum_profile/2020_216.SLDPRT
blueprint_platform/aluminum_profile/2020_215.SLDPRT
blueprint_platform/acrylic/acrylic_325x130_right_down_r.SLDPRT
blueprint_platform/battery_plat_mirror.SLDPRT
blueprint_platform/aluminum_profile/2020_Nut_M3.SLDPRT
blueprint_prototype/batt_plat.STL
blueprint_prototype/plat_main.STL
blueprint_prototype/plat_wheel.STL
