ZaowuHT/JussieuServiceRobot/(commit log)

2020-09-28 Service Robot.
    Service Robot.
    [2020.SLDPRT, 2020R_Movebase.SLDPRT, 2020R_body.SLDPRT, 2020_215.SLDPRT, 2020_216.SLDPRT, 2020_335.SLDPRT, 2020_410.SLDPRT, 2020_450.SLDPRT]
2020-10-05 DMA Support.
    DMA Support.
